raymirabel/MB_8RO/README.md

# MB_8RO
Módulo salida 8 relés con bus RS485

Características:
- Alimentación 100 - 260VAC o 6.5 - 30 VDC (según modelo).
- Microcontrolador Atmel ATmega328.
- 8 salidas relé.
- Protocolo MODBUS RTU cargado por defecto.
- Puerto de comunicaciones RS485 aislado.
- Regulador conmutado alta eficiencia.
- Compatible con Arduino Duemilanove ATMega328.
- Zócalo para RTC (opcional).
- Conector auxiliar I2C.
- Caja para carril DIN.
