raymirabel/MB_8RO/MB-8RO - SCHEMATIC.pdf

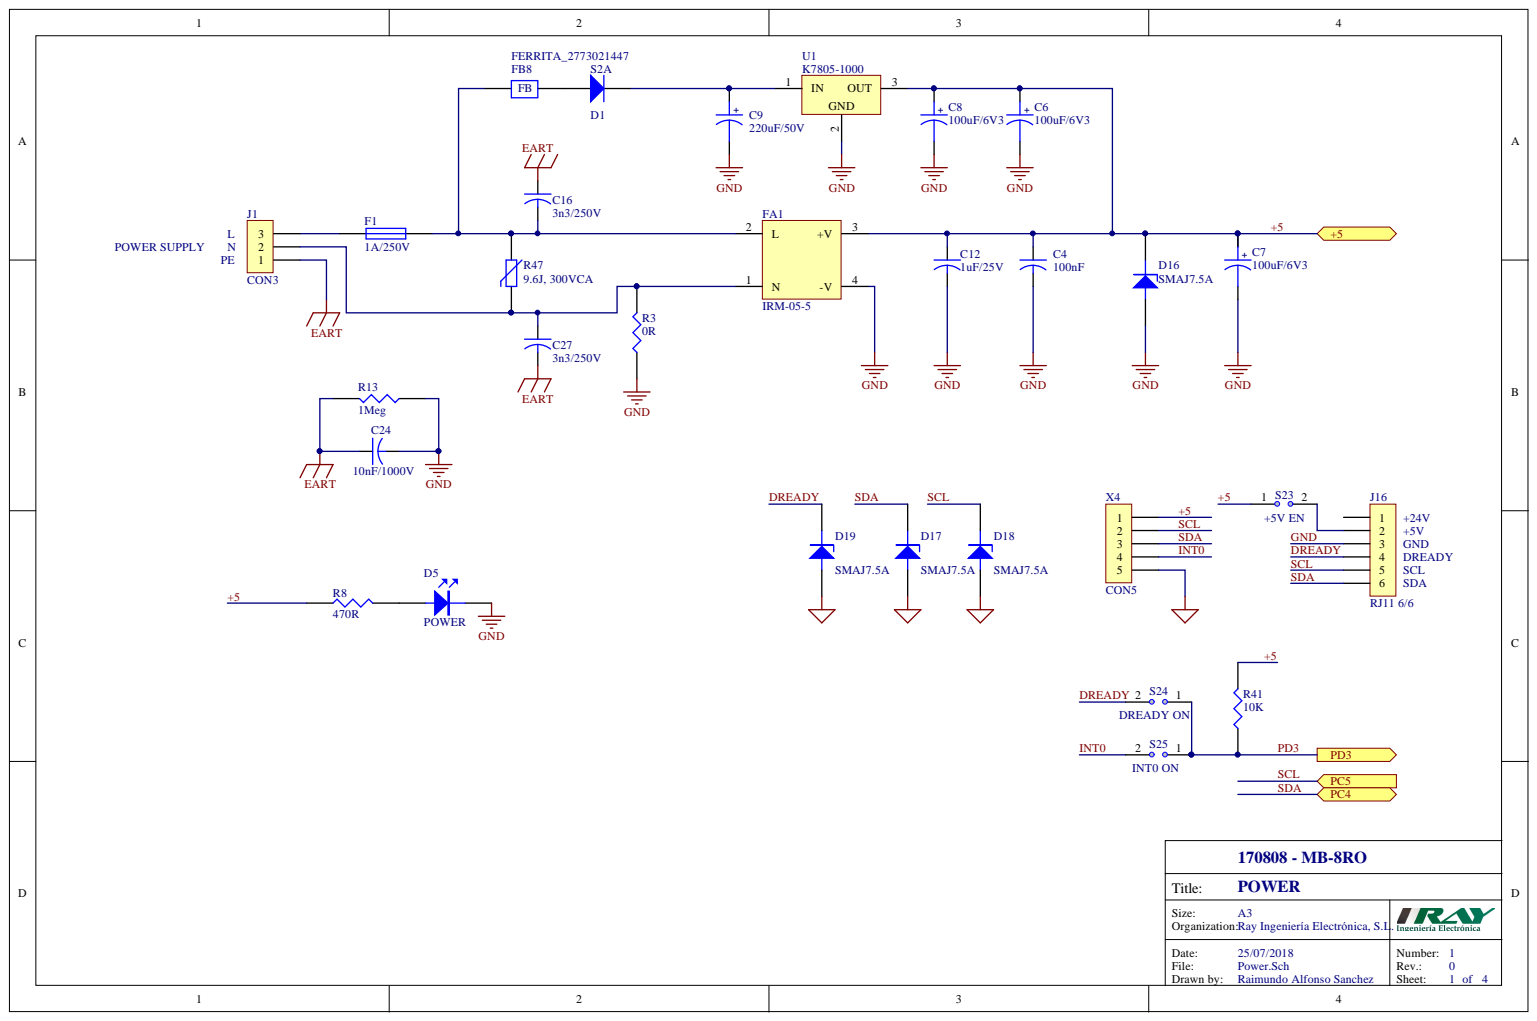
[picture p1: page 1]

Size: A3 Organization: Ray Ingeniería Electrónica, S.L.

Date: 25/07/2018 File: Power.Sch Drawn by: Raimundo Alfonso Sanchez | Number: 1 Rev.: Sheet: of

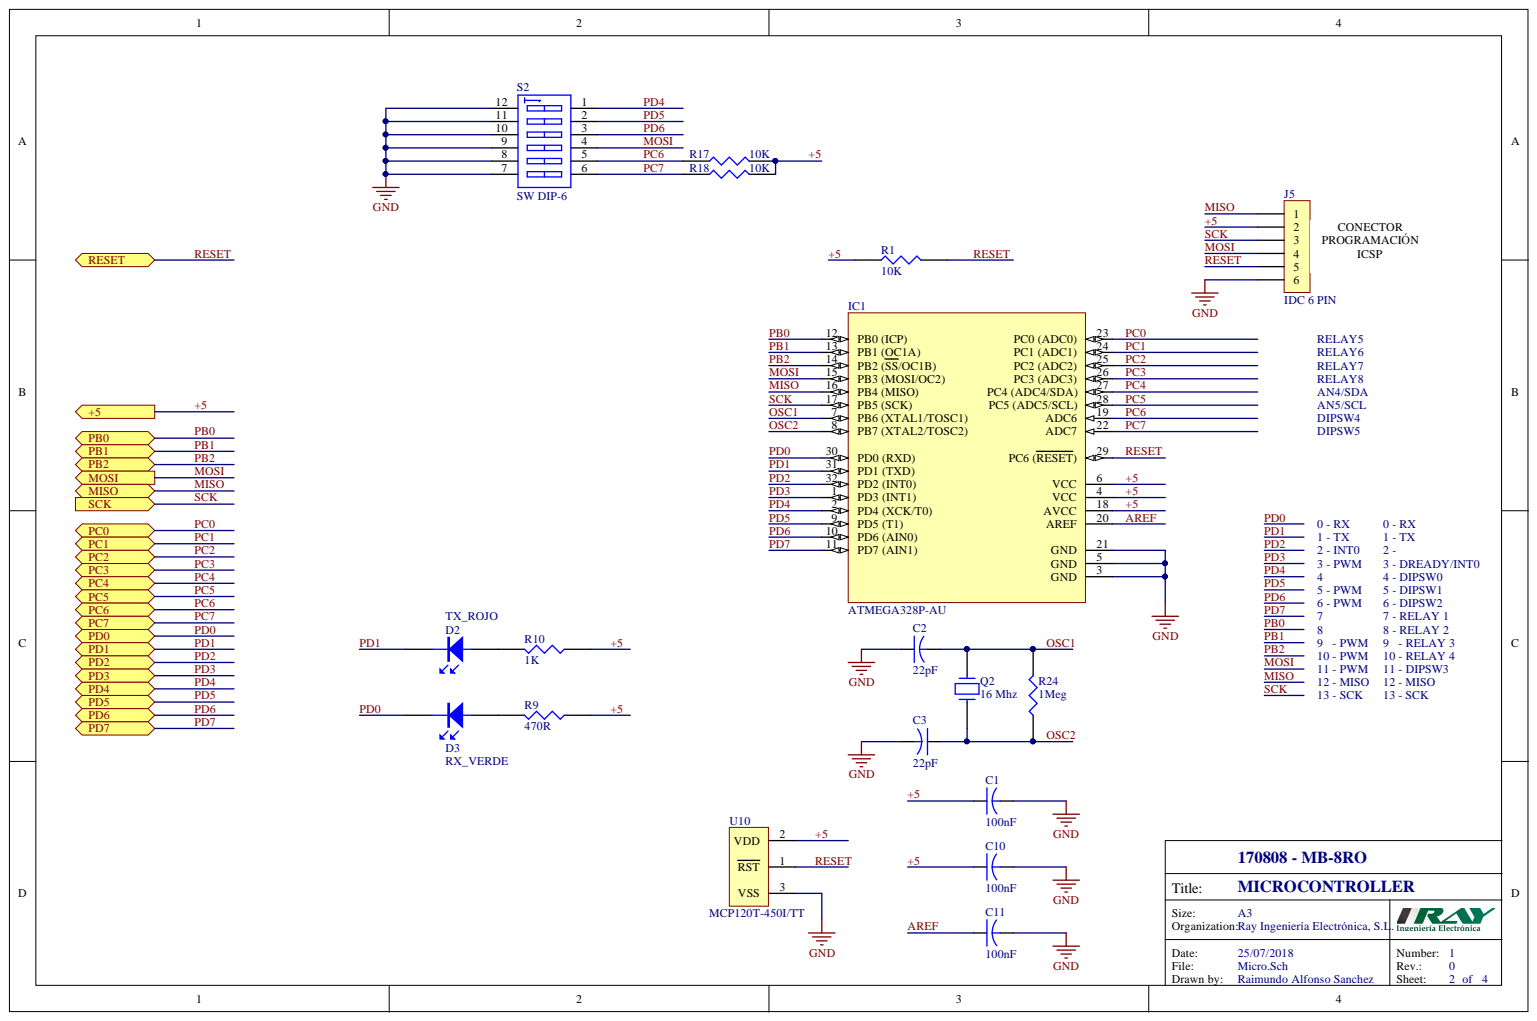
[picture p2: page 2]

Size: A 3 Organ izat i o n : Ray In gen ier ía E lect r ó n ica, S.L | .

Date: 2 5 / 0 7 / 2 0 1 8 Fi le: Micro.Sch Draw n b y : Raimu n d o A lfo n s o Sanchez | N umber: 1 Sheet : o f

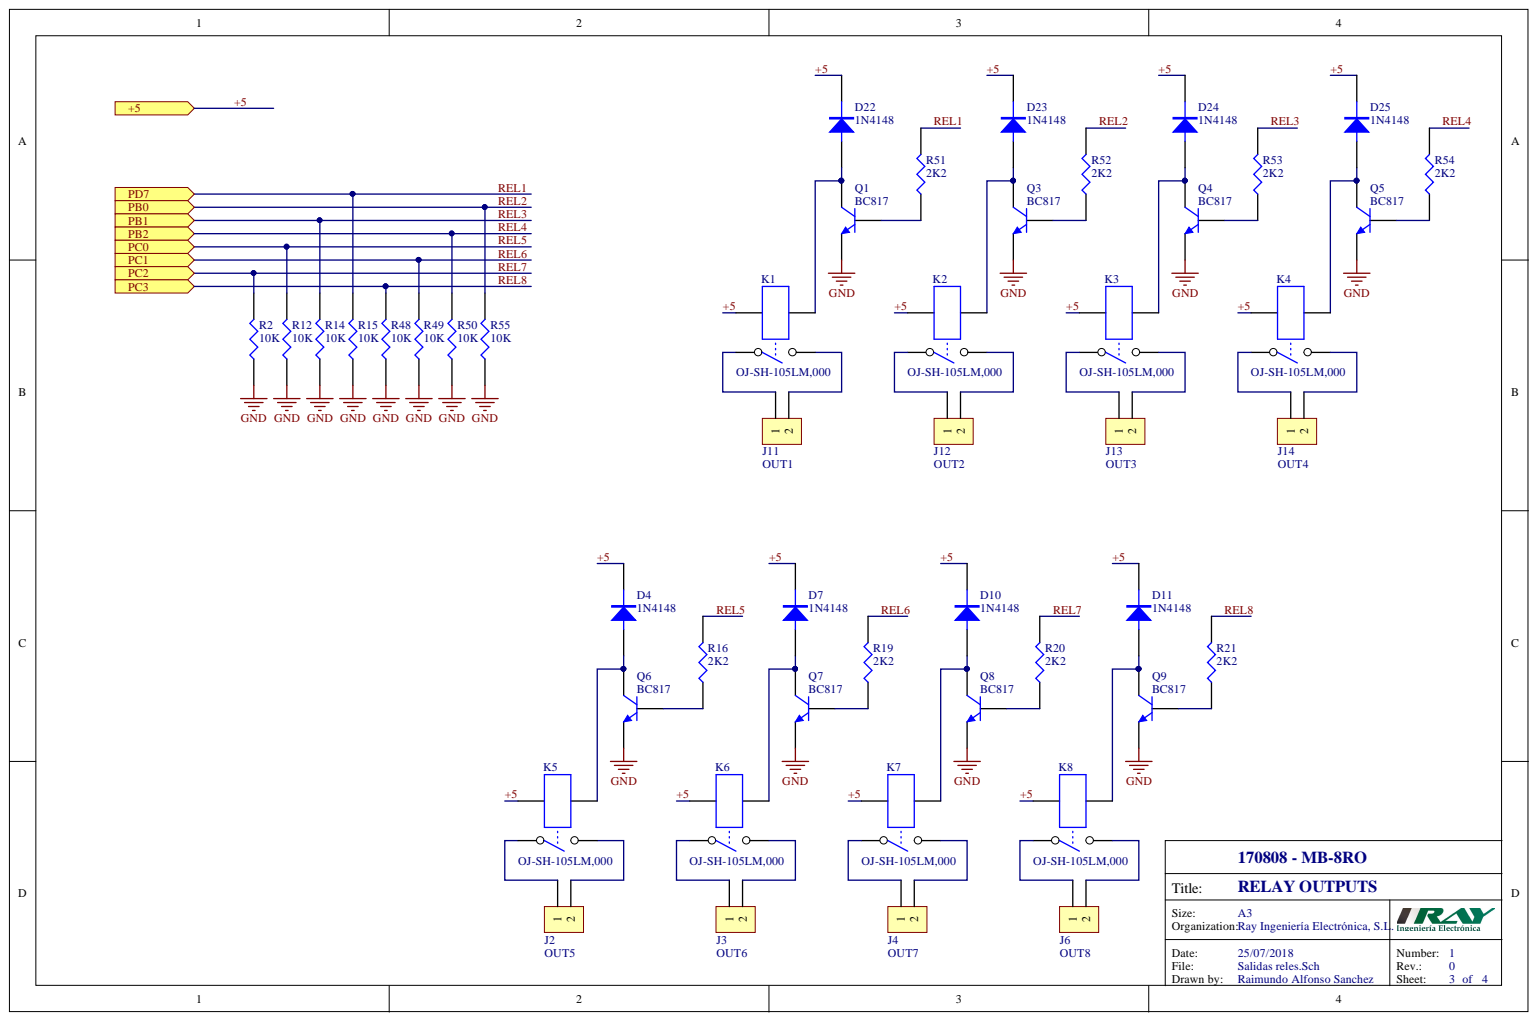
[picture p3: page 3]

GND GND

Size: A3 Organization: Ray Ingeniería Electrónica, S.L.

Date: 25/07/2018 Salidas reles.Sch | Number: 1 0

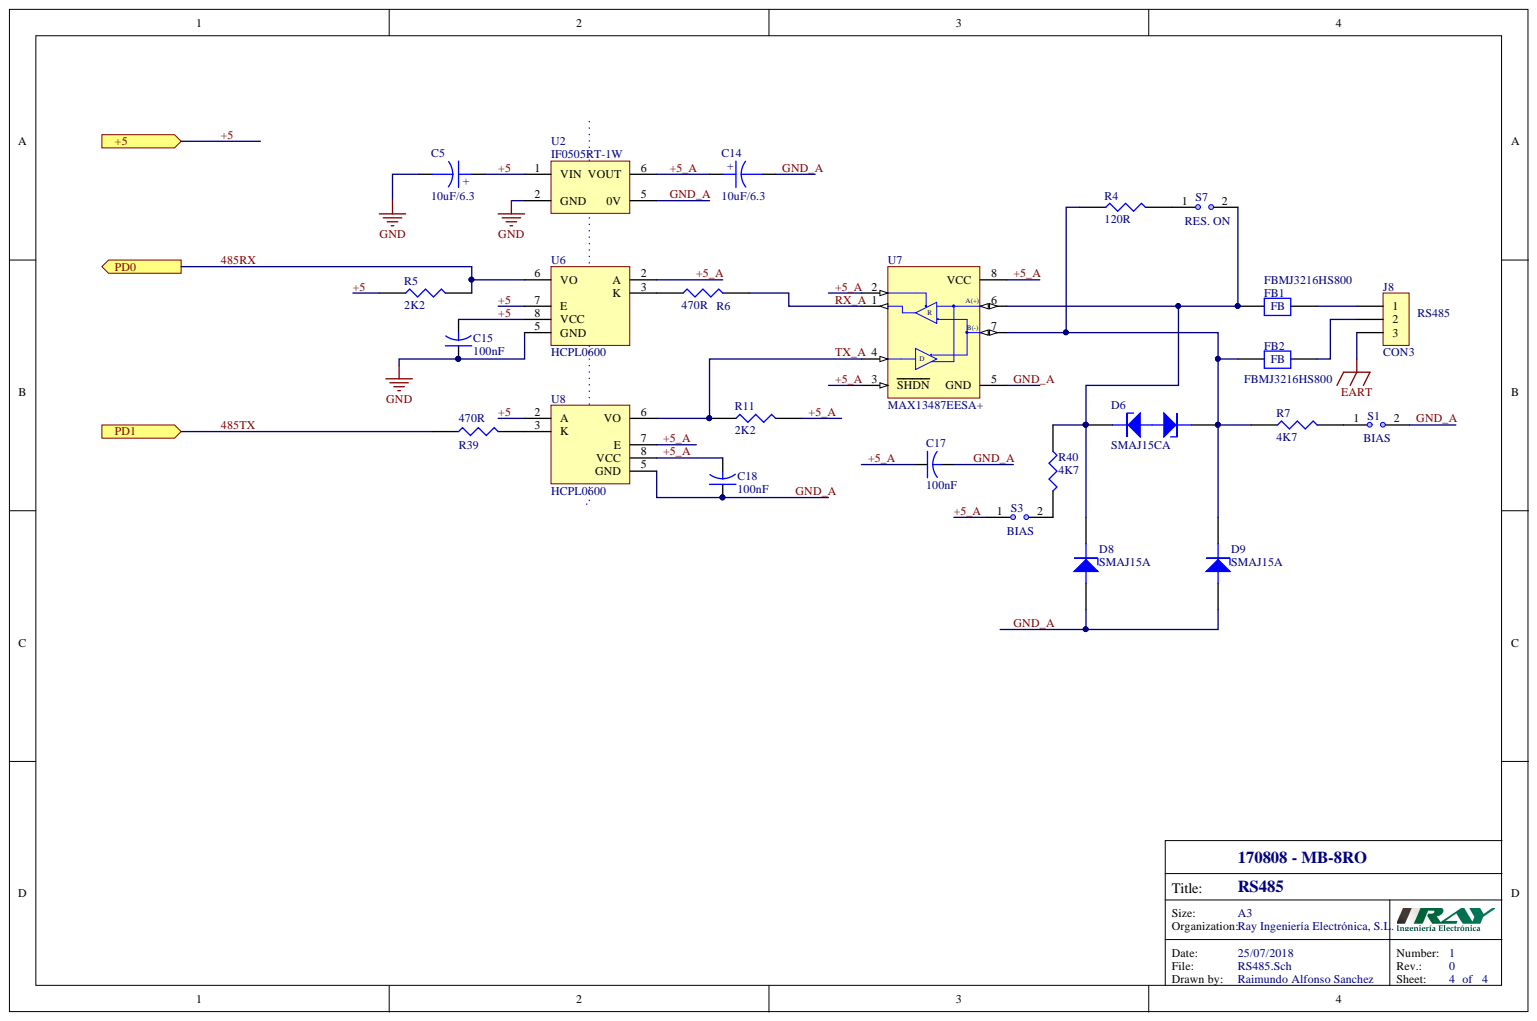
[picture p4: page 4]

GND 5

Size: A3 Organization: Ray Ingeniería Electrónica, S.L.

Date: 25/07/2018 RS485.Sch | Number: 1 0
